Albert-HY-Jiang/Buggy-for-Neural-Navigation/README.md

# Buggy-for-Neural-Navigation

This project involves designing and building a robotic buggy capable of collecting spatial and visual data to demonstrate a neural algorithm for navigation. 

Key Features:
- ARM core microcontroller MSP432P401R programmed using C
- Ultrasonic distance sensing for obstacle detection
- Camera module for real-time image capture
- Bluetooth communication for remote control and data transmission
- Microcontroller peripherals for motor control, sensor interfacing, and data handling
