Albert-HY-Jiang/Buggy-for-Neural-Navigation/doc/weekly reports/5-1 bluetooth transfer.docx

# Bluetooth Transfer from ESP32 Cam

The ESP32 cam has embedded Bluetooth module that can be initiated using BluetoothSerial.h.

With function SerialBT.begin(device_name), the device will appear with the provide name as the Bluetooth device. It can be connected to PC with “find Bluetooth Device” option. After connected, two serial ports will be added for connection.

Bluetooth serial has the similar functionality with regular serial like read, write, print, avail, etc. It can also register call back functions using SerialBT.register_callback(btCallback); This can be used to respond to different events, like connection, data input, etc.

The Bluetooth transmission is simply writing the whole frame buffer through the serial port. It seems like this process can’t be done under the call back function, or else the data will be lost through the Bluetooth transfer. Another potential reason is that the wireless transfer is inherently unreliable. So it might be required some kind of transfer protocol to detect the missing segments.

Currently, the transfer is fine with simply writing the whole frame buffer through serial port. However, the image capture will fail after the first capture.

On the PC, it can start the connection like other serial port using pyserial.

#include "esp_camera.h"

#include "Arduino.h"

#include "FS.h" // SD Card ESP32

#include "SD_MMC.h" // SD Card ESP32

#include "soc/soc.h" // Disable brownour problems

#include "soc/rtc_cntl_reg.h" // Disable brownour problems

#include "driver/rtc_io.h"

#include <EEPROM.h> // read and write from flash memory

#include "BluetoothSerial.h" //bluetooth

// define the number of bytes you want to access

#define EEPROM_SIZE 1

RTC_DATA_ATTR int bootCount = 0;

// Pin definition for CAMERA_MODEL_AI_THINKER

#define PWDN_GPIO_NUM 32

#define RESET_GPIO_NUM -1

#define XCLK_GPIO_NUM 0

#define SIOD_GPIO_NUM 26

#define SIOC_GPIO_NUM 27

#define Y9_GPIO_NUM 35

#define Y8_GPIO_NUM 34

#define Y7_GPIO_NUM 39

#define Y6_GPIO_NUM 36

#define Y5_GPIO_NUM 21

#define Y4_GPIO_NUM 19

#define Y3_GPIO_NUM 18

#define Y2_GPIO_NUM 5

#define VSYNC_GPIO_NUM 25

#define HREF_GPIO_NUM 23

#define PCLK_GPIO_NUM 22

//Example SerialtoSerialBT

// Check if Bluetooth is available

#if !defined(CONFIG_BT_ENABLED) || !defined(CONFIG_BLUEDROID_ENABLED)

#error Bluetooth is not enabled! Please run `make menuconfig` to and enable it

#endif

// Check Serial Port Profile

#if !defined(CONFIG_BT_SPP_ENABLED)

#error Serial Port Profile for Bluetooth is not available or not enabled. It is only available for the ESP32 chip.

#endif

#define CHUNK_SIZE (size_t)32

BluetoothSerial SerialBT;

String device_name = "ESP32_CAM_BT";

void setup() {

WRITE_PERI_REG(RTC_CNTL_BROWN_OUT_REG, 0); //disable brownout detector

Serial.begin(115200);

cam_init();

bt_init();

}

void loop() {

char read;

if(SerialBT.available())

{

read = SerialBT.read();

Serial.write(read);

if(read == 't')

take_picture();

else{

Serial.print("picture not taken");

SerialBT.print("picture not taken");

}

}

}

void cam_init()

{

Serial.setDebugOutput(true);

camera_config_t config;

config.ledc_channel = LEDC_CHANNEL_0;

config.ledc_timer = LEDC_TIMER_0;

config.pin_d0 = Y2_GPIO_NUM;

config.pin_d1 = Y3_GPIO_NUM;

config.pin_d2 = Y4_GPIO_NUM;

config.pin_d3 = Y5_GPIO_NUM;

config.pin_d4 = Y6_GPIO_NUM;

config.pin_d5 = Y7_GPIO_NUM;

config.pin_d6 = Y8_GPIO_NUM;

config.pin_d7 = Y9_GPIO_NUM;

config.pin_xclk = XCLK_GPIO_NUM;

config.pin_pclk = PCLK_GPIO_NUM;

config.pin_vsync = VSYNC_GPIO_NUM;

config.pin_href = HREF_GPIO_NUM;

config.pin_sscb_sda = SIOD_GPIO_NUM;

config.pin_sscb_scl = SIOC_GPIO_NUM;

config.pin_pwdn = PWDN_GPIO_NUM;

config.pin_reset = RESET_GPIO_NUM;

config.xclk_freq_hz = 20000000;

config.pixel_format = PIXFORMAT_JPEG;

if(psramFound()){

Serial.print("Using UXGA\n");

config.frame_size = FRAMESIZE_UXGA; // FRAMESIZE_ + QVGA|CIF|VGA|SVGA|XGA|SXGA|UXGA

config.jpeg_quality = 10;

config.fb_count = 2;

} else {

Serial.print("Using SVGA\n");

config.frame_size = FRAMESIZE_SVGA;

config.jpeg_quality = 12;

config.fb_count = 1;

}

// Init Camera

esp_err_t err = esp_camera_init(&config);

if (err != ESP_OK) {

Serial.printf("Camera init failed with error 0x%x", err);

return;

}

}

void bt_init()

{

SerialBT.begin(device_name);

SerialBT.register_callback(btCallback);

Serial.println("The device started, now you can pair it with bluetooth");

}

void btCallback(esp_spp_cb_event_t event, esp_spp_cb_param_t *param){

//Serial Port Profile (SPP) API

if(event == ESP_SPP_SRV_OPEN_EVT){

/*!< When SPP is initialized, the event comes */

Serial.println("Client Connected!");

}else if(event == ESP_SPP_DATA_IND_EVT){

/*!< When SPP connection received data, the event comes, only for ESP_SPP_MODE_CB */

// Serial.printf("ESP_SPP_DATA_IND_EVT len=%d, handle=%d", param->data_ind.len, param->data_ind.handle);

// Serial.printf("value is %.*s\n", param->data_ind.len, param->data_ind.data);

// char stringRead[50];

// if(param->data_ind.len < 50)

// {

// memcpy(stringRead, param->data_ind.data, param->data_ind.len);

// stringRead[param->data_ind.len] = 0;

// Serial.printf("value is %.*s\n", param->data_ind.len+1, stringRead);

// if(stringRead[0] == 't')

// {

// Serial.printf("take picture\n");

// take_picture();

// }

// }

// else

// {

// Serial.printf("picture not taken\n");

// }

}

}

void take_picture()

{

camera_fb_t * fb = NULL;

// Take Picture with Camera

pinMode(4, OUTPUT);

digitalWrite(4, HIGH);

fb = esp_camera_fb_get();

delay(1000);//This is key to avoid an issue with the image being very dark and green. If needed adjust total delay time.

fb = esp_camera_fb_get();

digitalWrite(4, LOW);

if(!fb) {

esp_camera_fb_return(fb);

Serial.println("Camera capture failed");

SerialBT.println("Camera capture failed");

return;

}

Serial.printf("transmission started\n");

Serial.printf("%u\n",fb->len);

SerialBT.printf("transmission started\n");

SerialBT.printf("%u\n",fb->len);

SerialBT.flush();

delay(10);

// size_t len = 0;

// while(len < fb->len){

// int packet_size = min(CHUNK_SIZE, fb->len - len);

// SerialBT.write(fb->buf+len, packet_size);

// Serial.printf("%u\n", len);

// len += CHUNK_SIZE;

// SerialBT.flush();

// delay(1);

// }

SerialBT.write(fb->buf, fb->len);

SerialBT.flush();

esp_camera_fb_return(fb);

digitalWrite(4, LOW);

}
