Albert-HY-Jiang/Buggy-for-Neural-Navigation/doc/report/ECE397 SP25 Albert Jiang Final Report.docx

# Robotic Buggy with Camera and Ultrasonic Sensor

# Abstract

The project is to develop a buggy that can collect visual data and measure distance while traversing through a maze. It adds the ESP32-CAM camera module to the previous version of buggy that has motors and ultrasonic sensor. The image captured by ESP32-CAM will be transmitted with the distance data through Bluetooth module embedded within it. To receive the data, a Python script is used to establish Bluetooth Connection as a serial port and save the image as JPG file with the time stamp and the distance as the file name.

# Goals

The goal of this project is to develop an enhanced buggy that integrates an ESP32-CAM module to capture and transmit visual and distance data via Bluetooth.

# Background

Bluetooth is a short-range wireless communication standard. Bluetooth uses low power wireless link at 2.4GHz, giving it a short range of 10 meters and vulnerable to interference. It is mainly used for portable devices to exchange files with host, like wireless headphone or speaker to mobile phone or laptop. (1)

# Method

The buggy has four main components: MSP432P401R microcontroller (MSP432), ESP32-CAM, HC-SR04 ultrasonic sensor, and two motors with H-bridge. The connection is shown in the diagram below.

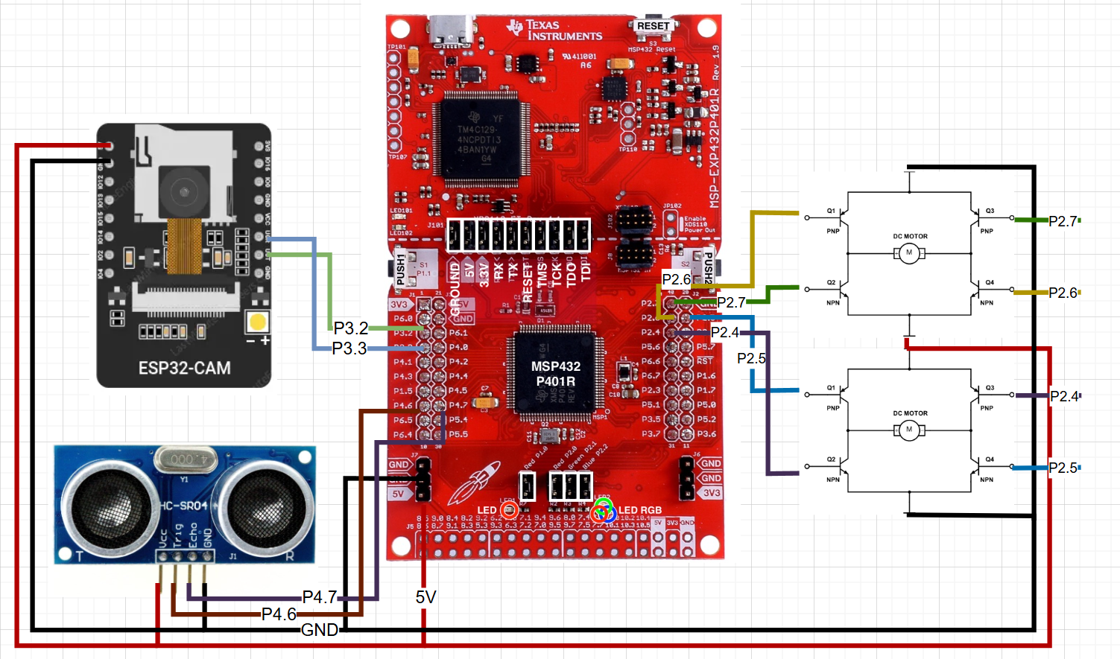
[picture p2: figure]

Figure 1. Schematic of the Buggy

The motor and the ultrasonic sensor are using the same method as the previous version, except the Trig and Echo pins for the ultrasonic sensor are moved to P4.6 and P4.7. And the previous code has been organized into different files based on the functionality. See Appendix for the code. The ESP32-CAM is connected to MSP432 by the UART port. So, they can communicate with the byte stream.

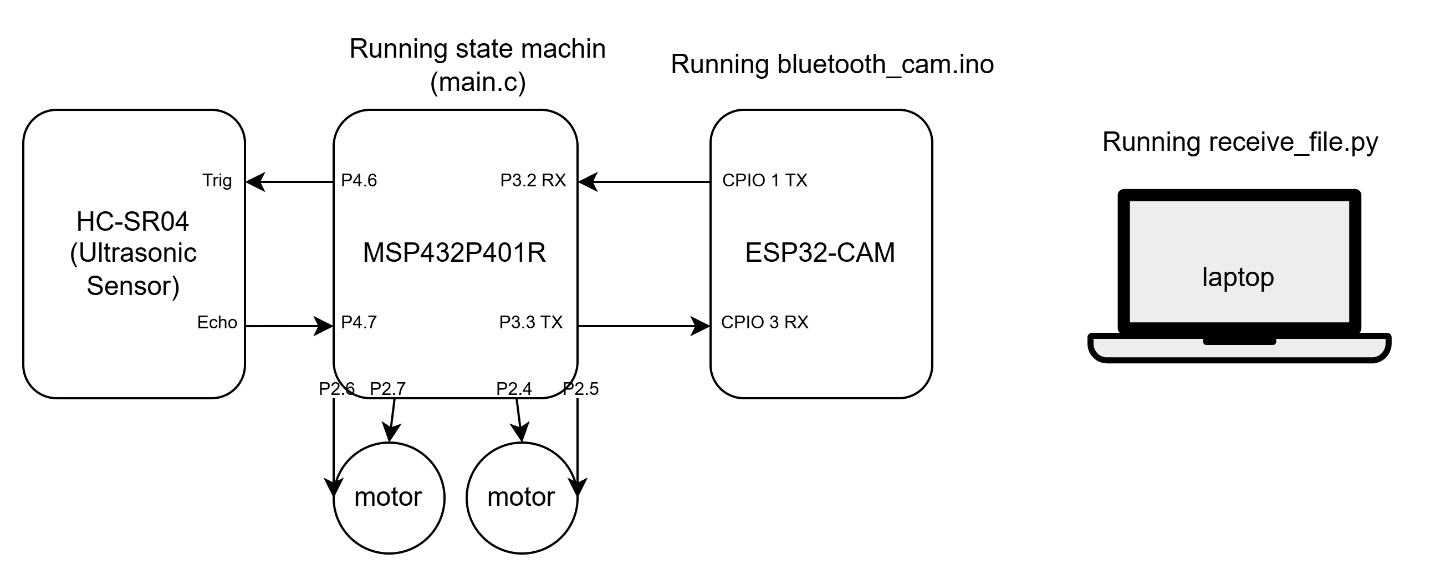
[picture p3: figure]

Figure 2. Diagram of the Buggy Set-up

## MSP432

The buggy has a state machine in MSP432 to control its behavior. It has four states: INIT, IDLE, MOVE, and SCAN. The buggy starts with INIT state to initialize all components.

case INIT:

//this state initialize all components

Clock_init();

motors_init(); //motors for moving

UART2_init(); //uart2(3.2, 3.3) for communicating with ESP32 cam

TIMERA0_init();

US_init();

currState = IDLE;

break;

Then it moves to IDLE state to wait for the ESP32-CAM to be ready. If it receives “go” from the camera module, it enables interrupt service routine to start the timer and ultrasonic sensor. Then it proceeds to the MOVE state.

case IDLE:

//this state wait for the ESP32 cam to be ready and send "go" through uart port

UART2_gets(readbuf);

if(strncmp(readbuf, "go",2) == 0)

{

__enable_irq();

// enables interrupts to start timer for time stamps, irq for ultrasonic sensor

currState = MOVE; // starts moving

}

break;

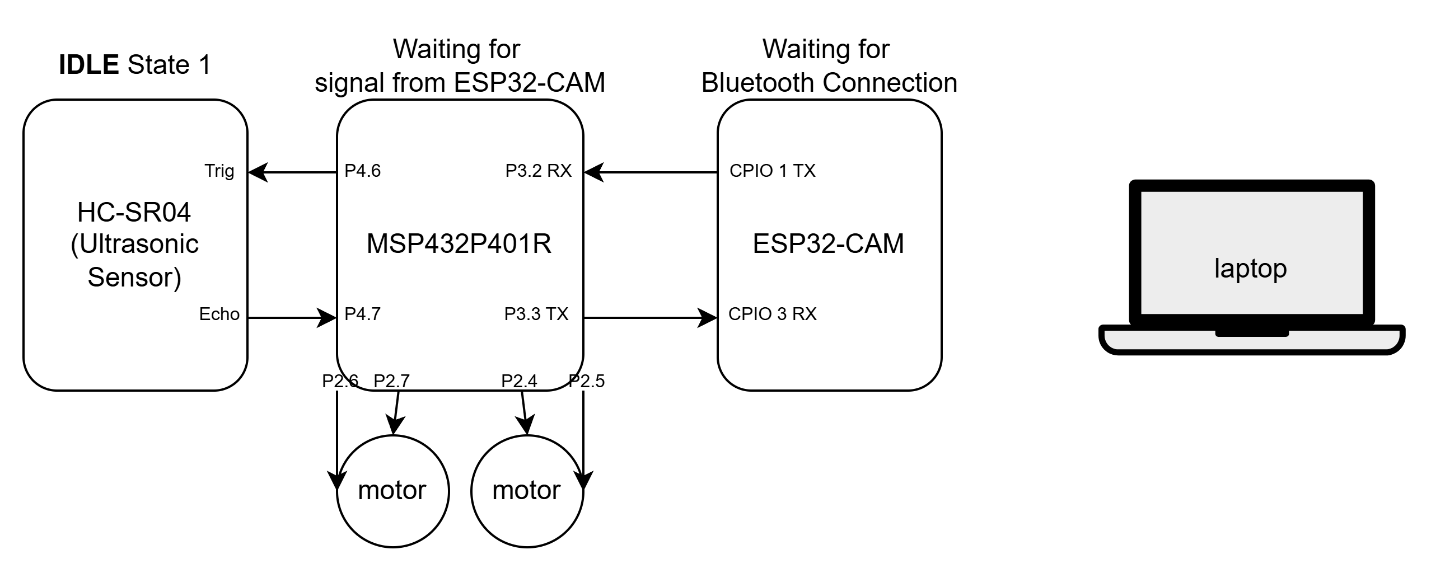
[picture p4: figure]
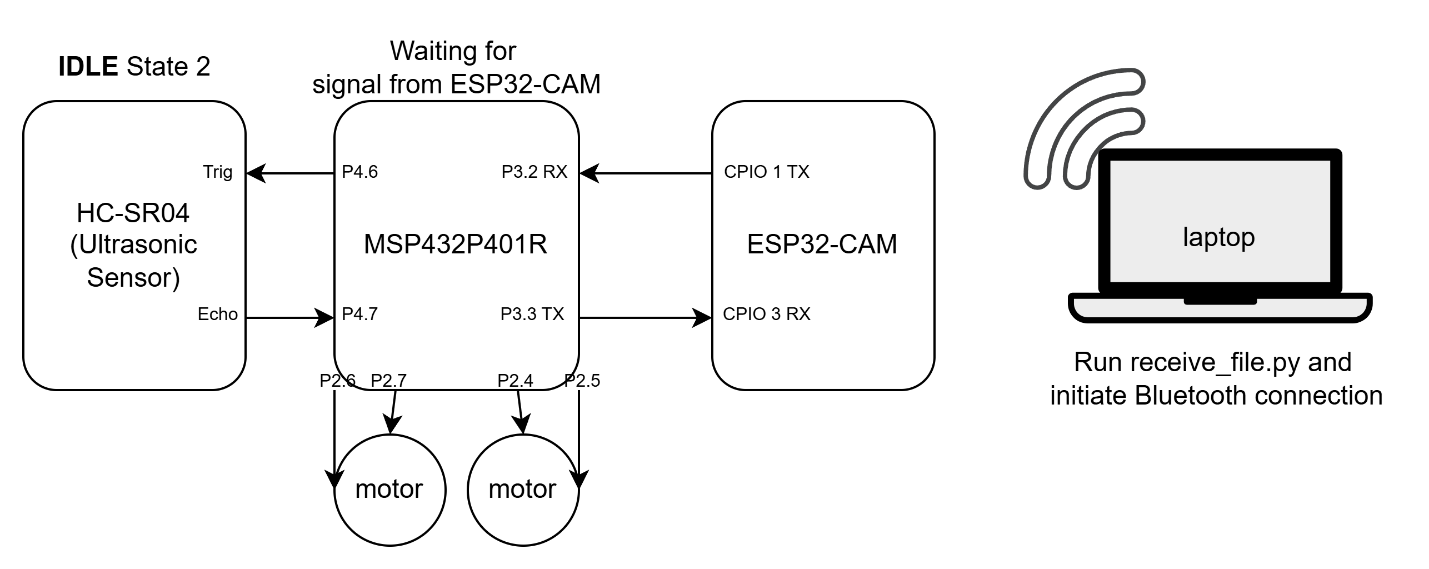
[picture p5: figure]
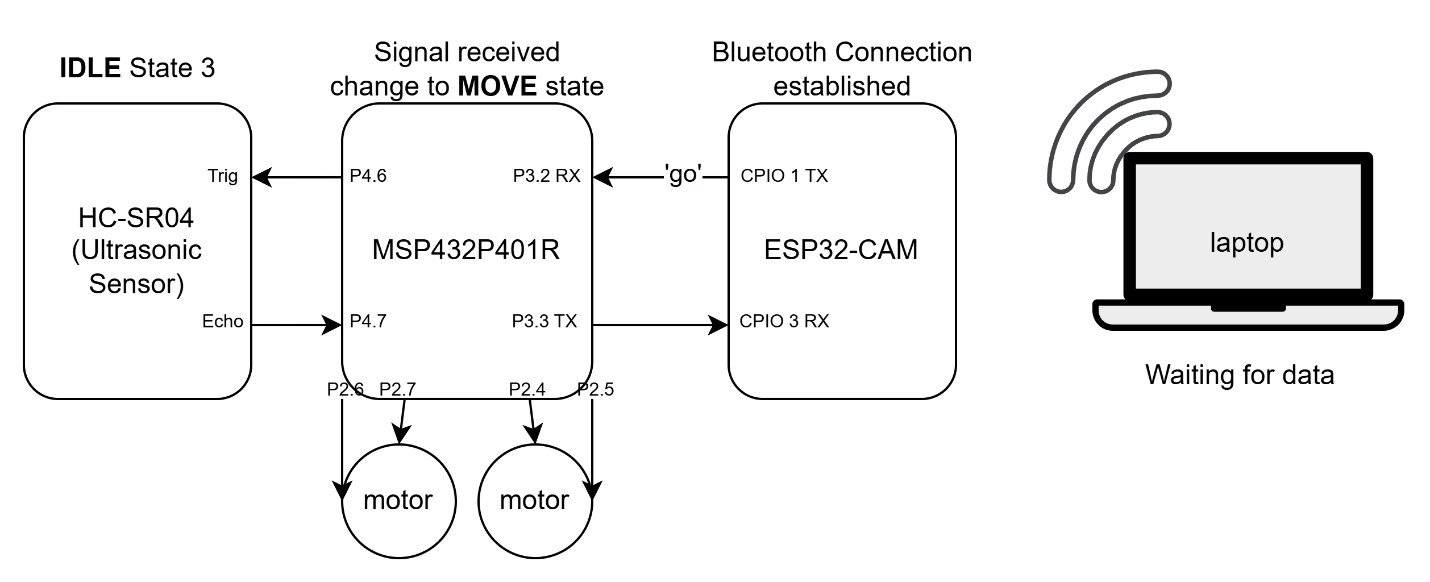
[picture p6: figure]

Figure 3. Flow Chart of IDLE State

In the MOVE state, the buggy will move forward and start scanning. The step buggy takes will be increased each time, so with the turn, the buggy will move in a triangular pattern.

case MOVE:

forward(unit_step * step); //the forward steps will gradually increase

step++;

currState = SCAN;

break;

In the SCAN state, the buggy will take two 120 degree turns. For each turn, it measures the distance by the ultrasonic sensor and gets the current time stamp. It sends the information to the ESP32-CAM through UART2 and waits for the ready signal to move on. It will end up taking a 240 degree turn and then change to MOVE state.

case SCAN:

for(i = 0; i < 2; i++){

distance = measure_dist();

time_stamp = get_time_stamp();

sprintf(writebuf, "%s, %d\n", time_stamp, distance); // format the output string

UART2_puts(writebuf); //write to ESP32 cam

UART2_gets(readbuf); //wait for ready signal from ESP32 cam

turn(-120); //it will end up turning for 240 degree

}

currState = MOVE;

break;

}

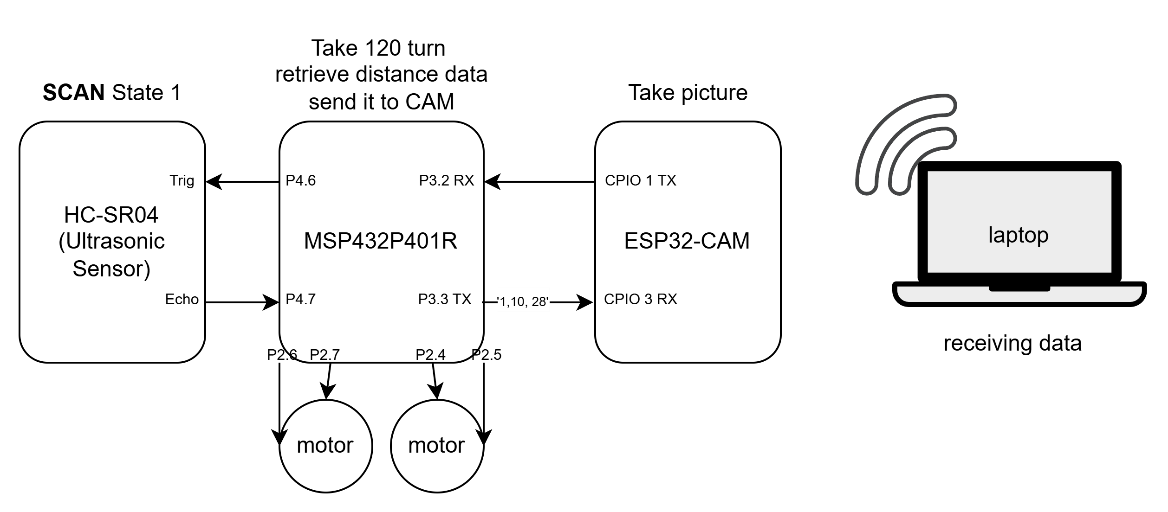
[picture p7: figure]
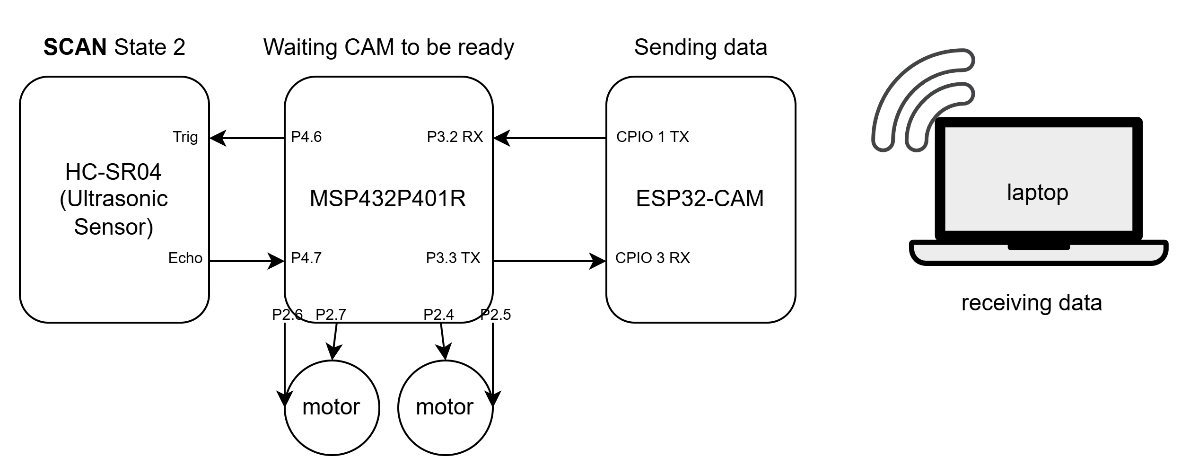
[picture p8: figure]
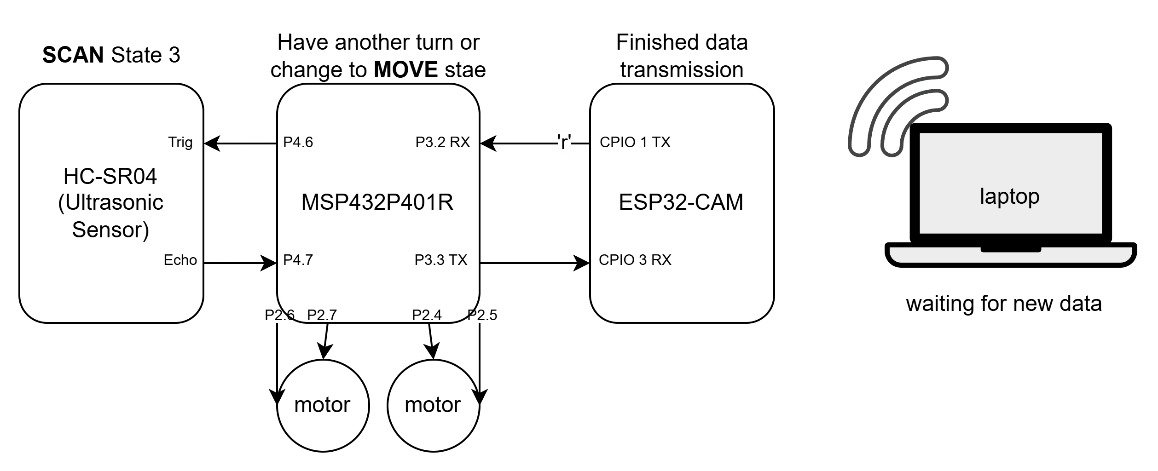
[picture p9: figure]

Figure 4. Flow Chart of SCAN State

The buggy will continue to oscillate between MOVE and SCAN state to move in triangular spiral and collect images. The reset button on the MSP432 can be used to break out of this loop. The buggy will then be reset and waiting in IDLE state. To start the run again, the laptop needs to restart the python script to establish Bluetooth connection again.

## ESP32-CAM

The ESP32-CAM is also a microcontroller, and it can be programmed using Arduino IDE

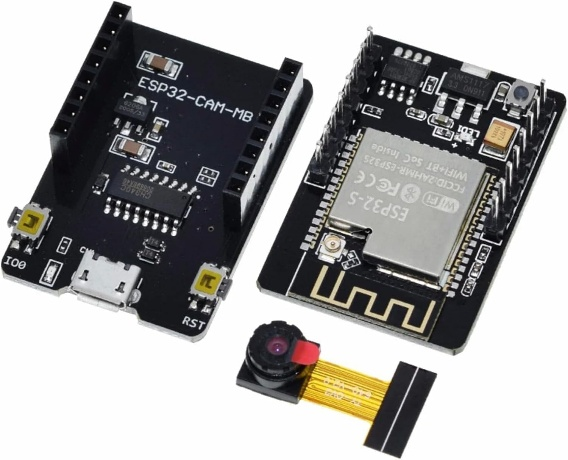
[picture p10: figure]

Figure 5. ESP32-CAm with OV2640 Camera

The ESP32-CAM doesn’t have a micro-USB port. It can be connected with ESP32-CAM-MB and use its micro-USB port. The micro-USB port is used for uploading the compiled program. In case when ESP32-CAM-MB isn’t available, FTDI jumper can be used for converting micro-USB to UART serial port. (2)

To compile ESP32 on Arduino, add the following link to Arduino IDE under Preferences->Additional Boards Manager->Additional Boards Manager URLs

https://raw.githubusercontent.com/espressif/arduino-esp32/gh-pages/package_esp32_index.json

Then go to Tools->Board->Board Manager. Install ESP32 by Expressif Systems.

Once Installed, go to Tools->Board->ESP32 Arduino->AI Thinker ESP32-CAM.

Connect ESP32 Cam and upload compiled code.

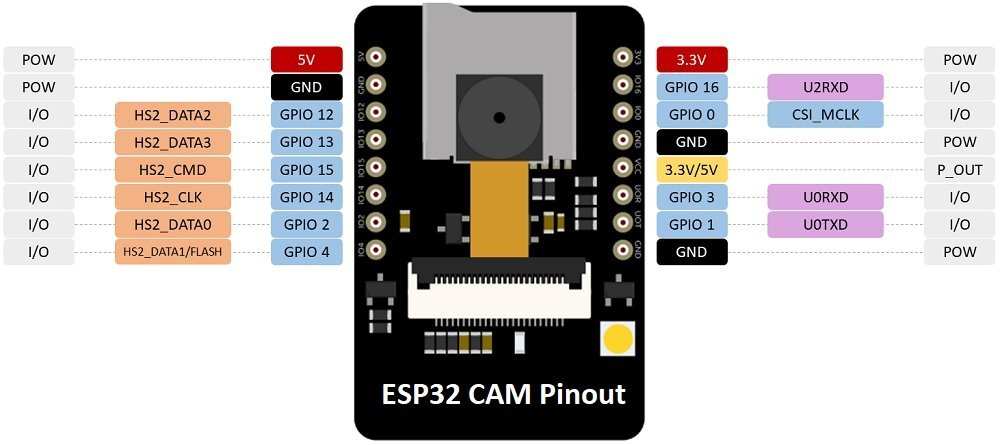
[picture p11: figure]
ESP32-CAM AI-Thinker: Pinout, GPIO Pins, Features and How to ...

Figure 6. ESP32 CAM Pin Configuration

## Serial Port

ESP32-CAM only has one full UART port (GPIO 1 and 3), which in our case will be used to communicate with MSP432 with its UART2 (P3.2 and P3.3). GPIO 1 and 3 are also used for sketch uploading. And because of the board configuration of ESP32-CAM, this serial port isn’t compatible with terminal emulator like Teraterm. It can be properly interpreted by Arduino serial monitor if the board configuration is loaded. The problem seems to be that ESP32-CAM disabled DTR and RTS, and if these are used, the board will keep rebooting. However, the exact solution to configure Teraterm to fit with this setting is still unknown. This will also mess up the transmission if directly connected to external Bluetooth module, like HC-06, for serial transmission. Direct connection to other microcontrollers like MSP432 through UART seems to be fine.

In order to receive serial data on a computer, pyserial library is used. It requires Python 2.7 or Python 3.4 and newer, which can be downloaded from official website with all released version https://www.python.org/downloads/ . And pyserial can be installed through pip through command line “python -m pip install pyserial”. (3) To establish the connection, it needs to create a Serial object with the port name and baud rate, like the example below:

com = serial.Serial()

com.port = port_name

com.baudrate = baud

com.timeout = 1

com.dsrdtr = False

com.open()

To resolve the issue of asserting DTR and RTS, it needs to initiate a port object and set dsrdtr to False before establishing the connection. With connection properly established, it can receive bytes from serial port and save it as jpg file.

## Camera on ESP32-CAM

ESP32-CAM needs to be configured and initialized to capture images. The specific configuration is in the Appendix. After it properly initialized, function esp_camera_fb_get() will return a struct of frame buffer(4):

typedef struct {

uint8_t * buf; /*!< Pointer to the pixel data */

size_t len; /*!< Length of the buffer in bytes */

size_t width; /*!< Width of the buffer in pixels */

size_t height; /*!< Height of the buffer in pixels */

pixformat_t format; /*!< Format of the pixel data */

struct timeval timestamp; /*!< Timestamp since boot of the first DMA buffer of the frame */

} camera_fb_t;

The frame buffer is at the buf pointer with the size of len. If it is properly configured, the buffer will be in the jpeg format. And these data can be transmitted as byte stream through serial port with Serial.write(fb->buf, fb->len). After each usage of the frame buffer, the memory needs to be freed by function esp_camera_fb_return(fb).

To take better quality pictures, it is recommended to use the flashlight at GPIO 4 and take one picture first to let the camera adjust itself and take the picture again. Like the example below

## Bluetooth Serial

camera_fb_t * fb = NULL;

// Take Picture with Camera

pinMode(4, OUTPUT); //GPIO 4 is the LED flashlight

digitalWrite(4, HIGH);

fb = esp_camera_fb_get();

esp_camera_fb_return(fb); //need to free frame buffer to prevent memory overflow

//Taking the picture twice allows the camera to adjust itself. It usually works better under brighter environment

delay(1000);

fb = esp_camera_fb_get();

digitalWrite(4, LOW);

The ESP32-CAM has embedded Bluetooth module that can be initiated using BluetoothSerial.h.

With the function SerialBT.begin(device_name), ESP32-CAM will appear with the provide name as the Bluetooth device. It can be connected to a computer with “find Bluetooth Device” option. After connected, two serial ports will be added for connection.

void btCallback(esp_spp_cb_event_t event, esp_spp_cb_param_t *param){

if(event == ESP_SPP_SRV_OPEN_EVT){

//this event corresponds to establishing bluetooth connection

//The "go" triggers MSP432 to start moving

Serial.println("go");

}

}

Bluetooth serial has similar functionality as regular serial port like read, write, print, avail, etc. It can also register call back functions using SerialBT.register_callback(btCallback); This is used to detect the event of establishing Bluetooth connection.

When the connection is established, ESP32-CAM sends the String “go\n” to the MSP432 through default serial port (GPIO 1 and 3). This corresponds to the “go” MSP432 is waiting for in the IDLE state.

After the connection is established, ESP32-CAM will be waiting for MSP432 to send the time stamp and the distance through UART. Each time ESP32-CAM receives the data, it will take a picture and transmit all the information through Bluetooth. The byte stream for each picture follows the structure below, so the receiver can parse all information properly.

/*

* structure of bytes stream transferred

* transmission started\n

* time stamp, distance\n

* file size(bytes)\n

* file bytes

*/

The Bluetooth transmission is similar with regular serial port with SerialBT.write(fb->buf, fb->len). It seems like this process can’t be done under the call back function, or else the data will be lost through Bluetooth transfer. After all transmission through Bluetooth, ESP32-CAM will send an arbitrary character to MSP432 as ready signal, marking it’s ready for the next picture.

## Python Script

The Python script is used to receive images on the computer. The pyserial library can read bytes from the serial port until a newline character by readline() or until the given number of bytes with read. After receiving all the information, it will create an image file with the time stamp and distance as the file name.

if(value == b'transmission started\n'):

name = com.readline()

file_name = str(name, encoding="UTF-8")[:-1]

print(file_name)

value = com.readline()

line = str(value, encoding="UTF-8")

file_len = int(line)

print(f'file size: {file_len} bytes')

start = time.time() #calculate tranmission time

file_buf = com.read(file_len)

print(len(file_buf))

with open(file_name+".jpg", "wb") as f: #save the image with time stamp, distance as file name

f.write(file_buf)

end = time.time()

print("picture captured")

print(end - start)

num +=1

## Procedures

1. Program MSP432 and ESP32-CAM
2. Connect all components together and power on, the buggy should then be waiting for Bluetooth connection
3. If the ESP32-CAM hasn’t been added as Bluetooth devices, use “Find Bluetooth Device” option on the computer to add it.
4. Run the Python Script on the computer, the buggy will start running and sending images to the computer
5. To stop the buggy, press the reset button on the MSP432. The buggy will reboot and waiting for Bluetooth connection.
6. To start another run, run the Python script on the computer again.

# Difficulties and Solutions

A summary of difficulties encountered during the project and their solutions

- Can’t read from ESP32-CAM serial port and the board is halted

Mostly likely because ESP32-CAM disabled DTR and RTS, and if these are used, the board will keep rebooting. So make sure the other end also disable these features. Serial monitor in Arduino IDE can communicate with it properly if the corresponding board configuration is loaded. If the connection is established through pyserial, initiate a port object and set dsrdtr to False before establishing the connection, like the example below

com = serial.Serial()

com.port = port_name

com.baudrate = baud

com.timeout = 1

com.dsrdtr = False

com.open()

- Bytes are dropped during Bluetooth transmission

Avoid starting the transmission after the callback function. This is probably because callback function limits the stack size to handle function calls and frame buffer. Smaller file size means a lower chance of dropping, and the size of image can be adjusted by setting config.frame_size to FRAMESIZE_ + QVGA, CIF, VGA, SVGA, XGA, SXGA, UXGA(size in increasing order). The regular Bluetooth connection should be reliable enough. To ensure a fully reliable transfer, certain kinds of protocol need to be implemented. For example, similar to TCP, the image file can be divided into packets and only send out the next packet after the receiver acknowledged the previous packet. However, this is an overkill and will significantly slow down the transmission.

- esp_camera_fb_get() fails

Probably because the previous frame buffer wasn’t freed by esp_camera_fb_return(). The camera can only hold the number of frame buffer according to config.fb_count

- picture is green with a lot of noise

The camera performs better under bright light. The quality of the picture can be improved by having multiple tries because the camera will configure itself after taking pictures.

# Result and Conclusion

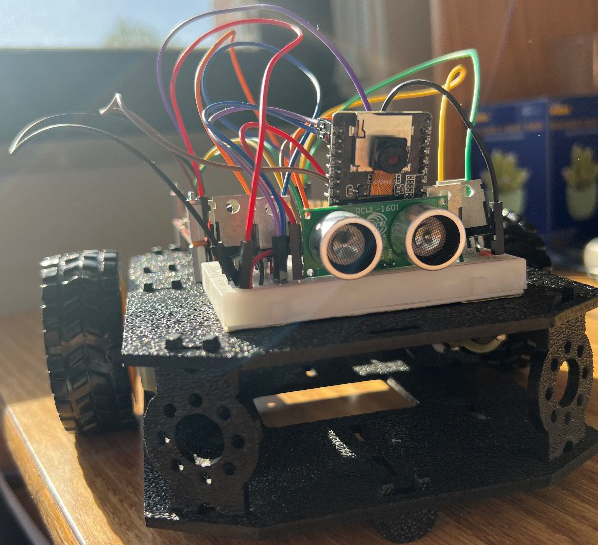
[picture p12: figure]
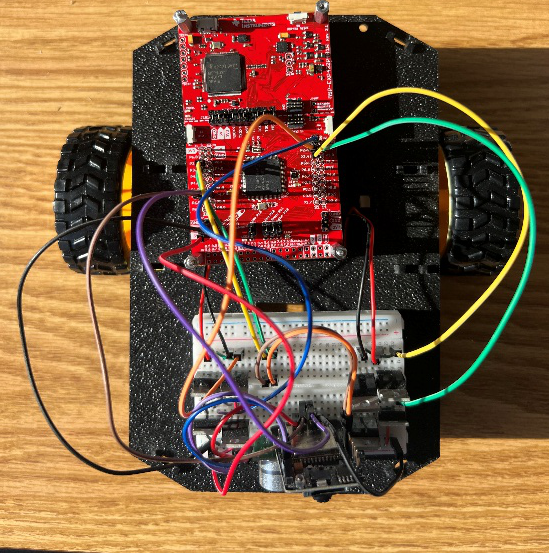
[picture p13: figure]

Figure 7. Side and Top view of Buggy

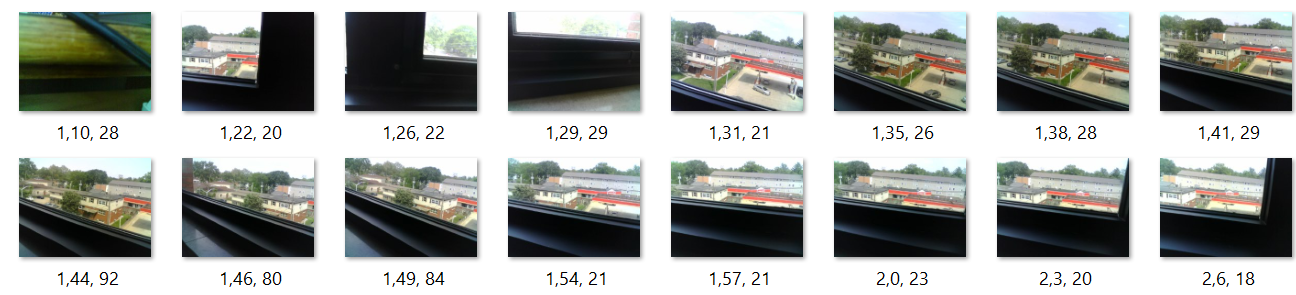
[picture p14: figure]

Figure 8. Received Example Images

The figures above are the final version of the buggy, and the image received in the test run. The Python Script can continuously receive images captured by the buggy and create files accordingly. This fulfills the goal of the project.

To further improve the buggy, we could use PCB for the circuit connection, which will greatly reduce the size of the buggy. The picture quality can be improved by using a different camera module. Bluetooth transmission is relatively slow due to its baud rate. We can speed up this process by changing to other wireless transmission like WiFi. The current buggy only takes command for starting the traversal and can only be terminated by the reset button. With Bluetooth or other transmission, it can potentially take in more commands like pause, continue, or even remote control of directions.

Reference

1. "About us – Bluetooth Technology Website". Bluetooth.com.
2. "ESP32-CAM Complete Guide". https://www.diyengineers.com/2023/04/13/esp32-cam-complete-guide/
3. "pyserial documentation". https://pyserial.readthedocs.io/en/latest/pyserial.html
4. "ESP32 Camera Driver". https://github.com/espressif/esp32-camera/blob/master/README.md

# Appendix

Box folder for code https://uofi.box.com/s/8n2sgsv3pwzodkihhqbszfubwpxs37ac

bluetooth_cam.ino

#include "esp_camera.h"

#include "Arduino.h"

#include "FS.h" // SD Card ESP32

#include "SD_MMC.h" // SD Card ESP32

#include "soc/soc.h" // Disable brownour problems

#include "soc/rtc_cntl_reg.h" // Disable brownour problems

#include "driver/rtc_io.h"

#include <EEPROM.h> // read and write from flash memory

#include "BluetoothSerial.h" //bluetooth

// define the number of bytes you want to access

#define EEPROM_SIZE 1

RTC_DATA_ATTR int bootCount = 0;

// Pin definition for CAMERA_MODEL_AI_THINKER

#define PWDN_GPIO_NUM 32

#define RESET_GPIO_NUM -1

#define XCLK_GPIO_NUM 0

#define SIOD_GPIO_NUM 26

#define SIOC_GPIO_NUM 27

#define Y9_GPIO_NUM 35

#define Y8_GPIO_NUM 34

#define Y7_GPIO_NUM 39

#define Y6_GPIO_NUM 36

#define Y5_GPIO_NUM 21

#define Y4_GPIO_NUM 19

#define Y3_GPIO_NUM 18

#define Y2_GPIO_NUM 5

#define VSYNC_GPIO_NUM 25

#define HREF_GPIO_NUM 23

#define PCLK_GPIO_NUM 22

//Example SerialtoSerialBT

// Check if Bluetooth is available

#if !defined(CONFIG_BT_ENABLED) || !defined(CONFIG_BLUEDROID_ENABLED)

#error Bluetooth is not enabled! Please run `make menuconfig` to and enable it

#endif

// Check Serial Port Profile

#if !defined(CONFIG_BT_SPP_ENABLED)

#error Serial Port Profile for Bluetooth is not available or not enabled. It is only available for the ESP32 chip.

#endif

#define CHUNK_SIZE (size_t)32

BluetoothSerial SerialBT;

String device_name = "ESP32_CAM_BT";

void setup() {

WRITE_PERI_REG(RTC_CNTL_BROWN_OUT_REG, 0); //disable brownout detector

Serial.begin(9600); //The MSP432 will be communicating through default serial port (GPIO 1 TX, GPIO 3 RX)

cam_init();

bt_init();

}

void loop() {

String read;

if(Serial.available())

{

//read time stamp and distance from MSP432

read = Serial.readString();

/*

* structure of bytes stream transferred

* transmission started\n

* time stamp, distance\n

* file size(bytes)\n

* file bytes

*/

SerialBT.printf("transmission started\n");

SerialBT.print(read);

take_picture();

//tell MSP432 the cam is ready again

Serial.print("r\n");

}

}

void cam_init()

{

Serial.setDebugOutput(false);

camera_config_t config;

config.ledc_channel = LEDC_CHANNEL_0;

config.ledc_timer = LEDC_TIMER_0;

config.pin_d0 = Y2_GPIO_NUM;

config.pin_d1 = Y3_GPIO_NUM;

config.pin_d2 = Y4_GPIO_NUM;

config.pin_d3 = Y5_GPIO_NUM;

config.pin_d4 = Y6_GPIO_NUM;

config.pin_d5 = Y7_GPIO_NUM;

config.pin_d6 = Y8_GPIO_NUM;

config.pin_d7 = Y9_GPIO_NUM;

config.pin_xclk = XCLK_GPIO_NUM;

config.pin_pclk = PCLK_GPIO_NUM;

config.pin_vsync = VSYNC_GPIO_NUM;

config.pin_href = HREF_GPIO_NUM;

config.pin_sscb_sda = SIOD_GPIO_NUM;

config.pin_sscb_scl = SIOC_GPIO_NUM;

config.pin_pwdn = PWDN_GPIO_NUM;

config.pin_reset = RESET_GPIO_NUM;

config.xclk_freq_hz = 20000000;

config.pixel_format = PIXFORMAT_JPEG;

//ESP32 cam will most likelt have psram, so it will be using UXGA

if(psramFound()){

Serial.print("Using UXGA\n");

config.frame_size = FRAMESIZE_UXGA; // FRAMESIZE_ + QVGA|CIF|VGA|SVGA|XGA|SXGA|UXGA

config.jpeg_quality = 10;

config.fb_count = 2; //it can holds two frame buffer at the same time

} else {

Serial.print("Using SVGA\n");

config.frame_size = FRAMESIZE_SVGA;

config.jpeg_quality = 12;

config.fb_count = 1;

}

// Init Camera

esp_err_t err = esp_camera_init(&config);

if (err != ESP_OK) {

Serial.printf("Camera init failed with error 0x%x", err);

return;

}

}

void bt_init()

{

SerialBT.begin(device_name);

SerialBT.register_callback(btCallback);

//Serial.println("The device started, now you can pair it with bluetooth");

}

void btCallback(esp_spp_cb_event_t event, esp_spp_cb_param_t *param){

//Serial Port Profile (SPP) API

if(event == ESP_SPP_SRV_OPEN_EVT){

//this event corresponds to establishing bluetooth connection

//The "go" triggers MSP432 to start moving

Serial.println("go");

}

}

void take_picture()

{

camera_fb_t * fb = NULL;

// Take Picture with Camera

pinMode(4, OUTPUT); //GPIO 4 is the LED flashlight

digitalWrite(4, HIGH);

fb = esp_camera_fb_get();

esp_camera_fb_return(fb); //need to free frame buffer to prevent memory overflow

//Taking the picture twice allows the camera to adjust itself. It usually works better under brighter environment

delay(1000);

fb = esp_camera_fb_get();

digitalWrite(4, LOW);

if(!fb) {

//notify each side the capture failed

Serial.println("Camera capture failed");

SerialBT.println("Camera capture failed");

return;

}

SerialBT.printf("%u\n",fb->len);

SerialBT.flush();

delay(10);

SerialBT.write(fb->buf, fb->len);

SerialBT.flush(); //make sure to transmit the whole file

esp_camera_fb_return(fb);

}

receive_file.py

import serial, time

import sys

if __name__ == '__main__':

if len(sys.argv) != 3:

#using the following command to run the script, baudrate is 115200 with bluetooth

print("python script serial_port baudrate")

#using the following command to list the available ports

print("python -m serial.tools.list_ports")

exit()

port_name = sys.argv[1]

baud = sys.argv[2]

#Create a Serial object, configure the parameters, then open the connection

#This is especially important when using wired connection with ESP32 cam

#because it will try to use dsrdtr regardless of the setting, which reset the board

com = serial.Serial()

com.port = port_name

com.baudrate = baud

com.timeout = 10

com.dsrdtr = False

com.open()

print("serial connected")

num = 1 #number of pictures received

while True:

print(num)

value = com.readline()

line = str(value, encoding="UTF-8")

print(line)

'''

structure of bytes stream transferred:

transmission started\n

time stamp, distance\n

file size(bytes)\n

file bytes

'''

if(value == b'transmission started\n'):

name = com.readline()

file_name = str(name, encoding="UTF-8")[:-1]

print(file_name)

value = com.readline()

line = str(value, encoding="UTF-8")

file_len = int(line)

print(f'file size: {file_len} bytes')

start = time.time() #calculate tranmission time

file_buf = com.read(file_len)

print(len(file_buf))

with open(file_name+".jpg", "wb") as f: #save the image with time stamp, distance as file name

f.write(file_buf)

end = time.time()

print("picture captured")

print(end - start)

num +=1

main.c

#include "msp.h"

#include <stdio.h>

#include <string.h>

#include "uart.h"

#include "motor.h"

#include "us.h"

#define unit_step 1000

enum buggieState {

INIT,

IDLE,

MOVE,

SCAN

};

void main(void)

{

WDT_A->CTL = WDT_A_CTL_PW | // Stop watchdog timer

WDT_A_CTL_HOLD;

char readbuf[128];

char writebuf[128];

int step = 1; //number of forward step taken at each round

long distance; //distance measured by ultrasonic sensor

char* time_stamp; //time stamp starting

int i;

enum buggieState currState = INIT;

while(1)

{

switch(currState)

{

case INIT:

//this state initialize all components

Clock_init();

motors_init(); //motors for moving

UART2_init(); //uart2(3.2, 3.3) for communicating with ESP32 cam

TIMERA0_init();

US_init();

currState = IDLE;

break;

case IDLE:

//this state wait for the ESP32 cam to be ready and send "go" through uart port

UART2_gets(readbuf);

if(strncmp(readbuf, "go",2) == 0)

{

__enable_irq(); // enables interrupts to start timer for time stamps, irq for ultrasonic sensor

currState = MOVE; // starts moving

}

break;

case MOVE:

forward(unit_step * step); //the forward steps will gradually increase

step++;

currState = SCAN;

break;

case SCAN:

for(i = 0; i < 2; i++){

distance = measure_dist();

time_stamp = get_time_stamp();

sprintf(writebuf, "%s, %d\n", time_stamp, distance); // format the output string

UART2_puts(writebuf); //write to ESP32 cam

UART2_gets(readbuf); //wait for ready signal from ESP32 cam

turn(-120); //it will end up turning for 240 degree

}

currState = MOVE;

break;

}

}

}

motor.h

#include "msp.h"

#include <stdio.h>

#include "SysTick0.h"

void motors_init(); // Initialize ports controlling H-Bridge

void forward(int time); // Move buggy forward for a time in ms

void backward(int time); // Move buggy backward for a time in ms

void turn(int angle); // Turn buggy by an angle in degrees

motor.c

#include "motor.h"

#define timePerAngle 10 // Constant to translate

void left_fw(); // Helper functions for H-Bridge

void left_bw();

void left_off();

void right_fw();

void right_bw();

void right_off();

void motors_init() {

P2->OUT = 0x00; // Set P2.4-2.7 to low GPIO out, 2.4, 2.5 for the left, 2.6, 2.7 for the right

P2->SEL0 = 0x00;

P2->SEL1 = 0x00;

P2->DIR = 0xF0;

return;

}

void left_fw() {

P2->OUT &= (~BIT5);

P2->OUT |= BIT4;

return;

}

void left_bw() {

P2->OUT &= (~BIT4);

P2->OUT |= BIT5;

return;

}

void left_off() {

P2->OUT &= (~(BIT4 | BIT5));

return;

}

void right_fw() {

P2->OUT &= (~BIT7);

P2->OUT |= BIT6;

return;

}

void right_bw() {

P2->OUT &= (~BIT6);

P2->OUT |= BIT7;

return;

}

void right_off() {

P2->OUT &= (~(BIT6 | BIT7));

return;

}

void forward(int time) {

right_fw(); // Make both motors spin forward for a set time

left_fw();

SysTick_Delayms(time);

right_off(); // Turn off both motors

left_off();

return;

}

void backward(int time) {

right_bw(); // Make both motors spin backwards for a set time

left_bw();

SysTick_Delayms(time);

right_off(); // Turn off both motors

left_off();

return;

}

void turn(int angle) {

if (angle == 0 || angle > 180 || angle < -180) { // Invalid angles

} else if (angle > 0){ // Counter-clockwise turns, spin right wheel forward and left wheel backwards

right_fw();

left_bw();

SysTick_Delayms(angle * timePerAngle);

right_off();

left_off();

} else { // Clockwise turns, spin left wheel forward and right wheel backwards

right_bw();

left_fw();

SysTick_Delayms(angle * (-1) * timePerAngle);

right_off();

left_off();

}

return;

}

uart.h

#include "msp.h"

//UART0 is at the micro-USB port. UART2 is at pin 3.2 and pin 3.3. These two ports allow serial communication between the microcontroller and the ESP32-CAM.

//This function initializes UART0.

void UART0_init();

//This function sends string through UART0 by spin waiting.

int UART0_puts(const char *str);

//This function initializes UART2.

void UART2_init();

//This function sends string through UART2 by spin waiting. The transmit pin is pin 3.3.

int UART2_puts(const char *str);

//This function receives string through UART2 by spin waiting. The receive pin is pin 3.2.

//It returns after the receiving line feed ‘\n’ or end of the string ‘\0’

int UART2_gets(char *str);

uart.c

#include "msp.h"

#include "uart.h"

void UART0_init();

int UART0_puts(const char *str);

void UART2_init();

int UART2_puts(const char *str);

int UART2_gets(char *str);

/**

* This function is initializing the UART0(micro-USB port) for sending distance message to the console with baud rate of 9600

*

*/

void UART0_init()

{

// Configure UART pins

P1->SEL0 |= BIT2 | BIT3; // set 2-UART pin as secondary function

// Configure UART

EUSCI_A0->CTLW0 |= EUSCI_A_CTLW0_SWRST; // Put eUSCI in reset

EUSCI_A0->CTLW0 |= EUSCI_B_CTLW0_SSEL__SMCLK; // Configure eUSCI clock source for SMCLK

// Baud Rate calculation

// 12000000/(16*9600) = 78.125

// Fractional portion = 0.125

// User's Guide Table 21-4: UCBRSx = 0x10

// UCBRFx = int ( (78.125-78)*16) = 2

EUSCI_A0->BRW = 78; // 12000000/16/9600

EUSCI_A0->MCTLW = (2 << EUSCI_A_MCTLW_BRF_OFS) |

EUSCI_A_MCTLW_OS16;

EUSCI_A0->CTLW0 &= ~EUSCI_A_CTLW0_SWRST; // take eUSCI out of reset mode

EUSCI_A0->IFG &= ~EUSCI_A_IFG_RXIFG; // Clear eUSCI RX interrupt flag

EUSCI_A0->IE &= ~EUSCI_A_IE_RXIE; // Disable USCI_A0 RX interrupt

}

/**

* This function puts a string to transmit buffer in the UART0, which will be sent to console

*/

int UART0_puts(const char *str)

{

int status = -1;

if (str != '\0')

{

status = 0;

while (*str != '\0')

{

/* Wait for the transmit buffer to be ready */

while (!(EUSCI_A0->IFG & EUSCI_A_IFG_TXIFG))

;

/* Transmit data */

EUSCI_A0->TXBUF = *str;

/* If there is a line-feed, add a carriage return */

if (*str == '\n')

{

/* Wait for the transmit buffer to be ready */

while (!(EUSCI_A0->IFG & EUSCI_A_IFG_TXIFG))

;

EUSCI_A0->TXBUF = '\r';

}

str++;

}

}

return status;

}

/**

* This function is initializing the UART2(pin 3.2,3.3) for sending distance message to the console with baud rate of 9600

*

*/

void UART2_init()

{

//pin 3.2 RX pin 3.3 TX

// Configure UART pins

P3->SEL0 |= BIT2 | BIT3; // set 2-UART pin as secondary function

P3->SEL1 &= ~(BIT2 | BIT3);

// Configure UART

EUSCI_A2->CTLW0 |= EUSCI_A_CTLW0_SWRST; // Put eUSCI in reset

EUSCI_A2->CTLW0 |= EUSCI_B_CTLW0_SSEL__SMCLK; // Configure eUSCI clock source for SMCLK

// Baud Rate calculation

// 12000000/(16*9600) = 78.125

// Fractional portion = 0.125

// User's Guide Table 21-4: UCBRSx = 0x10

// UCBRFx = int ( (78.125-78)*16) = 2

EUSCI_A2->BRW = 78; // 12000000/16/9600

EUSCI_A2->MCTLW = (2 << EUSCI_A_MCTLW_BRF_OFS) |

EUSCI_A_MCTLW_OS16;

EUSCI_A2->CTLW0 &= ~EUSCI_A_CTLW0_SWRST; // take eUSCI out of reset mode

EUSCI_A2->IFG &= ~EUSCI_A_IFG_RXIFG; // Clear eUSCI RX interrupt flag

EUSCI_A2->IE &= ~EUSCI_A_IE_RXIE; // Disable USCI_A2 RX interrupt

}

/**

* This function puts a string to transmit buffer in the UART2, which will be sent to console

*/

int UART2_puts(const char *str)

{

int status = -1;

if (str != '\0') {

status = 0;

while (*str != '\0') {

/* Wait for the transmit buffer to be ready */

while (!(EUSCI_A2->IFG & EUSCI_A_IFG_TXIFG));

/* Transmit data */

EUSCI_A2->TXBUF = *str;

str++;

}

}

return status;

}

int UART2_gets(char *str)

{

while (1) {

/* Wait for the receive buffer to be ready */

while (!(EUSCI_A2->IFG & EUSCI_A_IFG_RXIFG));

/* Transmit data */

*str = EUSCI_A2->RXBUF;

if(*str == '\n' || *str == '\0')

{

break;

}

str++;

}

return 1;

}

_______________________________

"us.h"

#include "msp.h"

#include <stdint.h>

#include <stdio.h>

//higher number has lower priority

#define PORT4_PRIO 4

#define TIMEA0_PRIO 3

#define INTR_PRD 1000

#define DIST_DIV 1400

#define SAMPLE_SIZE 3

//This function initializes the clock signal

void Clock_init();

//This function initializes the TIMERA0 for recording time_stamp

void TIMERA0_init();

//This function initializes pins for trigger ultrasonic sensor and record echo signals.

//It uses pin 4.6 as trigger and pin 4.7 for echo. It also registers IRQ for receiving interrupt from rising or falling edge at pin 4.7

void US_init();

//This function measures the distance between the ultrasonic sensor and the object in front of it.

//It triggers the sensor several times and return the average value in cm.

//The specific size of the sample can be modified by changing the macro in us.h. The range of distance is (0, 300)

long measure_dist();

//This function returns the time passed since the start of the measurement (marked by US_init). The time stamp is record as â€œmin,secâ€ in string

char* get_time_stamp();

void Delay(uint32_t tick);

us.c

#include "us.h"

long intrcnt = 0;

long clktick = 0;

long start = 0;

long end = 0;

int min = 0;

int sec = 0;

char buffer[20];

long US_scan_once();

void Clock_init()

{

//setting up clock signals

CS->KEY = CS_KEY_VAL; // Unlock CS module for register access

CS->CTL0 = 0; // Reset tuning parameters

CS->CTL0 = CS_CTL0_DCORSEL_3; // Set DCO to 24MHz

CS->CTL1 = CS_CTL1_SELA_2 | // Select ACLK = REFO

CS_CTL1_SELS_3 | // SMCLK = DCO

CS_CTL1_SELM_3; // MCLK = DCO

CS->KEY = 0; // Lock CS module from unintended accesses

}

void TIMERA0_init()

{

//setting up timer A0

TIMER_A0->CCTL[0] = TIMER_A_CCTLN_CCIE; // CCR0 interrupt enabled

TIMER_A0->CCR[0] = INTR_PRD - 1; // interrupt is raised for every 1000 clock tick

TIMER_A0->CTL = TIMER_A_CTL_TASSEL_2 | TIMER_A_CTL_MC__UP | TIMER_A_CTL_CLR; // SMCLK, upmode, TA clear

// Enable Timer interrupt for timing and set priority as 3

NVIC_SetPriority(TA0_0_IRQn, TIMEA0_PRIO);

NVIC_EnableIRQ(TA0_0_IRQn);

}

void US_init()

{

// Configure GPIO

//set P4 as GPIO

P4->SEL0 = 0;

P4->SEL1 = 0;

// uses P4.7 as echo

P4->DIR &= ~BIT7; // P4.7 as input pin

P4->REN |= BIT7; // P4.7 pull resistor enabled

P4->OUT &= ~BIT7; // P4.7 selected as pull down (active low)

// uses P4.6 as trigger

P4->DIR |= BIT6; // trigger pin as output

// receiving interrupt from P4.7

P4->IFG = 0; // clean pending interrupt flag

P4->IES &= ~BIT7; // enable rising edge interrupt

P4->IE |= BIT7; // enable interrupt

// Enable Port4 interrupt for echo and set priority as 4

NVIC_SetPriority(PORT4_IRQn, PORT4_PRIO);

NVIC_EnableIRQ(PORT4_IRQn);

}

/**

* This function delay for the given amount of clock cycle

*/

void Delay(uint32_t tick)

{

// initialize timer32 1 with give amount of tick

TIMER32_1->LOAD = tick;

//no prescaler, periodic wrapping mode, disable interrupt, 32-bit timer

TIMER32_1->CONTROL = 0xc2;

//spin wait until the time is reached

while ((TIMER32_1->RIS & 1) == 0)

;

TIMER32_1->INTCLR = 0; //clear raw interrupt flag

}

long US_scan_once()

{

// uses pin 4.6 for trigger

P4->OUT |= BIT6; // generate pulse

Delay(240); // 240 cycle in 24mhz is about 10us

P4->OUT &= ~BIT6; // stop pulse

P4->IFG = 0; // clear P4 interrupt just in case anything happened before

P4->IES &= ~BIT7; // wait for rising edge on ECHO pin

Delay(660000); //set this to 100us - 60ms

if(end > start)

{

return (end - start) / DIST_DIV; // converting ECHO time into cm

}

else

{

return 300;

}

}

long measure_dist()

{

long res = 0;

int i;

for(i = 0; i < SAMPLE_SIZE; i++)

{

long dist = US_scan_once();

if(dist > 300)

res += 300;

else

res += dist;

}

return res/SAMPLE_SIZE;

}

char* get_time_stamp()

{

sec = intrcnt / 24000;

min = sec / 60;

sec %= 60;

sprintf(buffer, "%d,%d", min, sec);

return buffer;

}

/**

* Port4 interrupt service routine, start timing echo from rising edge to falling edge

*/

void PORT4_IRQHandler(void)

{

// check if interrupt is pending for P4.7

if (P4->IFG & BIT7)

{

//if we are checking for raising edge, we are at the beginning of the echo

if (!(P4->IES & BIT7 ))

{

//record starting time of the echo

start = intrcnt * 1000 + (long) TIMER_A0->R;

//now checks for falling edge, which is the end of the echo

P4->IES |= BIT7;

}

else

{

end = intrcnt * 1000 + (long) TIMER_A0->R; //calculating ECHO length

//now back to checking rising edge, which is the beginning of the echo

P4->IES &= ~BIT7;

}

P4->IFG &= ~BIT7; //clear flag

}

}

/**

* TimerA0 interrupt service routine, updates count of interrupt and clears interrupt flag

*/

void TA0_0_IRQHandler(void)

{

// Interrupt gets triggered for every 1000 clock cycle in SMCLK

intrcnt++;

TIMER_A0->CCTL[0] &= ~TIMER_A_CCTLN_CCIFG;

}

Systick0.h

// Header to initialize SysTick for simple delay in ms or us

#include "msp.h"

#include <stdio.h>

void SysTick_Init();

void SysTick_Delayms();

void SysTick_Delayus();

Systick0.c

// Functions to initialize SysTick for simple delay in ms or us

#include "msp.h"

#include <stdio.h>

#include "SysTick0.h"

void SysTick_Init();

void SysTick_Delayms();

void SysTick_Delayus();

// Function to initialize SysTick without interrupt enable

// No longer necessary, delay functions work indpendently

void SysTick_Init(){

SysTick->CTRL = 0; // disable

SysTick->LOAD = 0x00FFFFFF; // set reload to max

SysTick->VAL = 0; // clear counter value

SysTick->CTRL = 0x00000005 ; // set CLKSOURCE to core clock and enable to 1

// clock is 3MHz, CTRL has interrupts disabled

// tech reference manual 2.4.4.1

return;

}

// Delay function with argument in milliseconds

void SysTick_Delayus(int time){

SysTick->LOAD = (time * 3 - 1); // 3000t / 3 MHz = t ms

// minimum 25 us, scales oddly until ~100 us

SysTick->VAL = 0; // any write to VAL clears VAL, restart

SysTick->CTRL = 0x00000005 ; // set CLKSOURCE to core clock and enable to 1

while(!(SysTick->CTRL & 0x00010000)); // stays in loop until COUNTFLAG is true

return;

}

// Delay function with argument in milliseconds

void SysTick_Delayms(int time){

SysTick->LOAD = (time * 3000 - 1); // 3000t / 3 MHz = t ms

SysTick->VAL = 0; // any write to VAL clears VAL, restart

SysTick->CTRL = 0x00000005 ; // set CLKSOURCE to core clock and enable to 1

while(!(SysTick->CTRL & 0x00010000)); // stays in loop until COUNTFLAG is true

return;

}
