Albert-HY-Jiang/Buggy-for-Neural-Navigation/doc/weekly reports/2-26 bluetooth log.docx

# Guide to Connect HC-06 Bluetooth Module

1. Power the HC-06 module with 5/3.3V to Vcc pin, and ground to GND pin. The LED will start flashing if the module is ready to connect.
2. Select find Bluetooth device on the laptop, make sure to choose “find all devices”. The name “HC-06” will show up. Enter the default pin “1234” to connect.
3. After pairing is completed, the device will be shown as “not connected”. This is expected. Under the Bluetooth device settings, there should be two new COM Ports added called “HC-06 port” and “HC-06”.
4. Use a terminal monitor, like TeraTerm or CoolTerm, to connect to serial port with name “HC-06 port” with outgoing direction. The LED on the device will stay on if the connection is successfully established.

# Communicate with HC-06 with UART

1. HC-06 has two pins, “TX” and “RX”, for UART communication. Any serial input to the RX pin will be transmitted to the connected serial port by the HC-06 module. Similarly, any serial data received by the HC-06 will be transmitted to the TX pin.

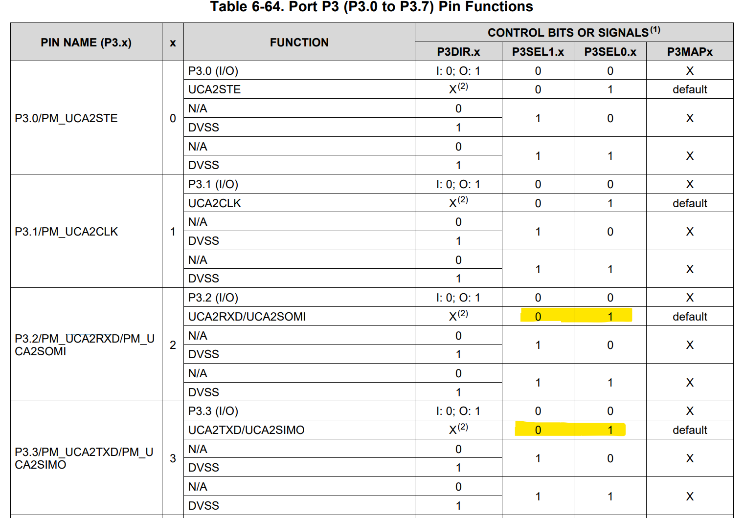
[picture p15: figure]

2. MSP432P401R has UART port available on the pins. The UART mode can be initiated by adjusting the control bit. For example, to set pin3.2 and pin3.3 to the UART mode, we need follow the table below

Set the P3SEL1.2/P3SEL1.3 = 0 and the P3SEL0.2/P3SEL0.3 = 1. It can be done by the code below.

3. For the wire connection, pin 3.2 RX need to be connected to TX on HC-06, and pin 3.3 TX need to be connected to RX on HC-06.
4. Then for transmitting data, it will be the same for regular UART functions. Wait for the flag for buffer to be ready and write the char data to the buffer.

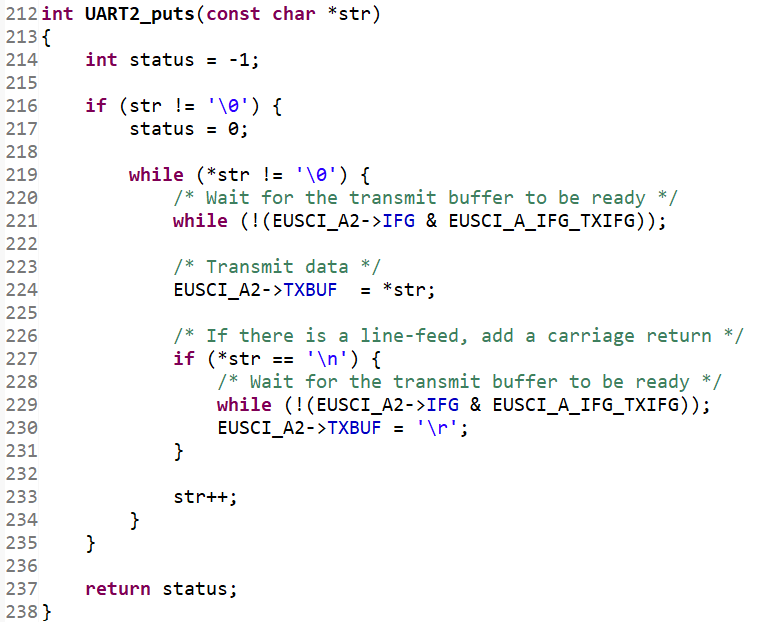
[picture p16: figure]

# Guide to Capture Serial Input with CoolTerm

1. Download CoolTerm on the official website https://freeware.the-meiers.org/
2. Unzip and start the program
3. Select Connection -> File Capture -> Start. A window will pop out to ask to save the file.

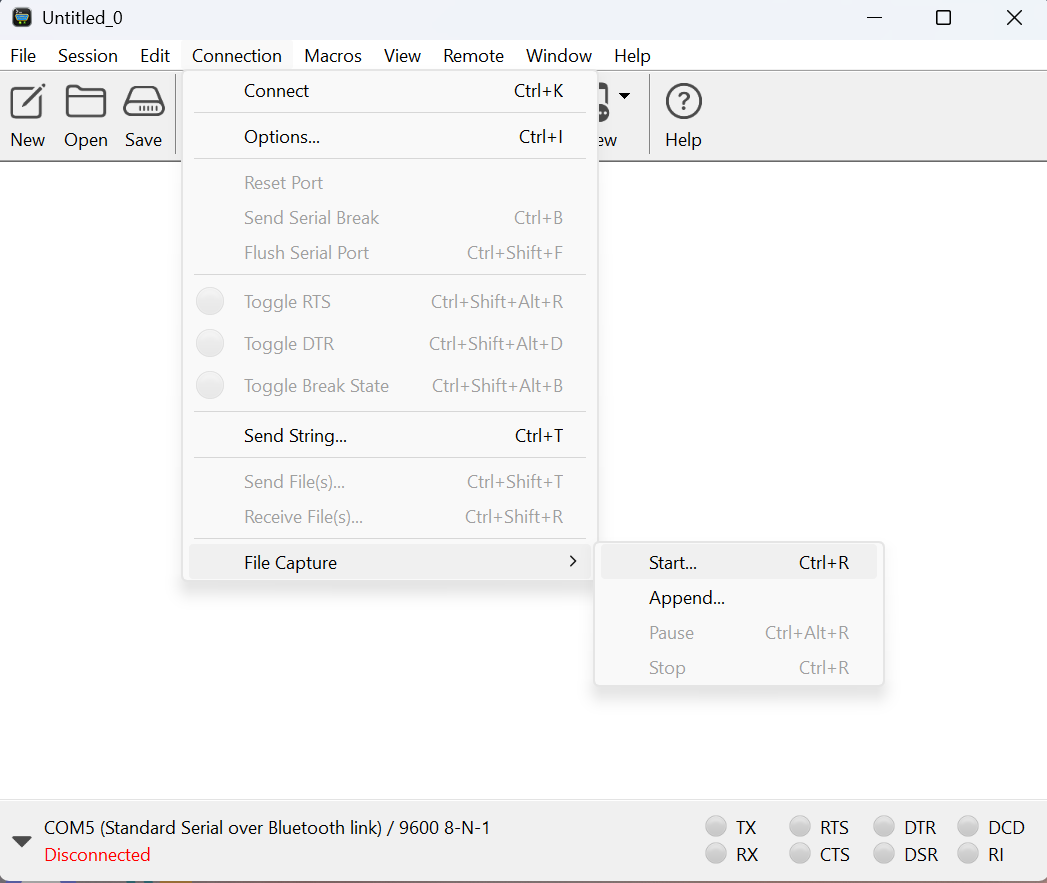
[picture p17: figure]

4. After saving the txt file, the connection can be started by clicking the arrow at the bottom left corner.
5. The setting for the connection can also be adjusted at the drop down manual.

Nearest distance by USG sensor – 1.97cm, longest sensor – 2.97m.

Distance between triggers should be more than 60 ms.

Appendix

#include "msp.h"

#include <stdint.h>

#include <stdio.h>

//higher number has lower priority

#define PORT2_PRIO 4

#define TIMEA0_PRIO 3

#define MCLKFREQ

#define INTR_PRD 1000

#define DIST_DIV 1400

//according to HCSR-04 datasheet, trigger length is 10us and max echo length is 60ms

//by my measurement, the echo length is from 135us to 55ms

long intrcnt = 0;

long distance = 0;

long clktick = 0;

long timestamp = 0;

long start = 0;

long end = 0;

void UART0_init();

int UART0_puts(const char *str);

void UART2_init();

int UART2_puts(const char *str);

void Delay(uint32_t tick);

long measure_dist();

void get_time_stamp();

int min = 0;

int sec = 0;

/**

* The main function initializes all port, including, UART, trigger, echo. And keep triggering

* the ultrasonic sensor and send the distance converted from echo length to the console

*/

int main(void)

{

WDT_A->CTL = WDT_A_CTL_PW | // Stop watchdog timer

WDT_A_CTL_HOLD;

//setting up clock signals

CS->KEY = CS_KEY_VAL; // Unlock CS module for register access

CS->CTL0 = 0; // Reset tuning parameters

CS->CTL0 = CS_CTL0_DCORSEL_3; // Set DCO to 24MHz

CS->CTL1 = CS_CTL1_SELA_2 | // Select ACLK = REFO

CS_CTL1_SELS_3 | // SMCLK = DCO

CS_CTL1_SELM_3; // MCLK = DCO

CS->KEY = 0; // Lock CS module from unintended accesses

UART2_init();

// Configure GPIO

// Setting up LED for distance detecting

P1->DIR |= BIT0; // Set P1.0 as output

//set p2 as GPIO

P2->SEL0 = 0;

P2->SEL1 = 0;

// uses p2.7 as echo

P2->DIR &= ~BIT7; // P2.7 as input pin

P2->REN |= BIT7; // P2.7 pull resistor enabled

P2->OUT &= ~BIT7; // P2.7 selected as pull down (active low)

// uses p2.6 as trigger

P2->DIR |= BIT6; // trigger pin as output

// receiving interrupt from p2.7

P2->IFG = 0; // clean pending interrupt flag

P2->IES &= ~BIT7; // enable rising edge interrupt

P2->IE |= BIT7; // enable interrupt

//setting up timer A0

TIMER_A0->CCTL[0] = TIMER_A_CCTLN_CCIE; // CCR0 interrupt enabled

TIMER_A0->CCR[0] = INTR_PRD - 1; // interrupt is raised for every 1000 clock tick

TIMER_A0->CTL = TIMER_A_CTL_TASSEL_2 | TIMER_A_CTL_MC__UP | TIMER_A_CTL_CLR; // SMCLK, upmode, TA clear

// Enable Port2 interrupt for echo and set priority as 4

NVIC_SetPriority(PORT2_IRQn, PORT2_PRIO);

NVIC_EnableIRQ(PORT2_IRQn);

// Enable Timer interrupt for timing and set priority as 3

NVIC_SetPriority(TA0_0_IRQn, TIMEA0_PRIO);

NVIC_EnableIRQ(TA0_0_IRQn);

__enable_irq(); // Enables interrupts to the system

//blink twice before it begin

P1->OUT |= BIT0;

Delay(24000000);

P1->OUT &= ~BIT0;

Delay(24000000);

P1->OUT |= BIT0;

Delay(24000000);

P1->OUT &= ~BIT0;

intrcnt = 0;

while (1)

{

distance = measure_dist();

get_time_stamp();

char buffer[50];

sprintf(buffer, "%d:%d, %d\n", min,sec, distance); // format the output string

UART2_puts(buffer);

//turning LED on if distance is less than certain range and if distance isn't 0.

if (distance < 50 && distance != 0)

P1->OUT |= BIT0;

else

P1->OUT &= ~BIT0;

Delay(300000);

}

}

/**

* This function is initializing the UART0 for sending distance message to the console with baud rate of 9600

*

*/

void UART0_init()

{

// Configure UART pins

P1->SEL0 |= BIT2 | BIT3; // set 2-UART pin as secondary function

// Configure UART

EUSCI_A0->CTLW0 |= EUSCI_A_CTLW0_SWRST; // Put eUSCI in reset

EUSCI_A0->CTLW0 |= EUSCI_B_CTLW0_SSEL__SMCLK; // Configure eUSCI clock source for SMCLK

// Baud Rate calculation

// 12000000/(16*9600) = 78.125

// Fractional portion = 0.125

// User's Guide Table 21-4: UCBRSx = 0x10

// UCBRFx = int ( (78.125-78)*16) = 2

EUSCI_A0->BRW = 78; // 12000000/16/9600

EUSCI_A0->MCTLW = (2 << EUSCI_A_MCTLW_BRF_OFS) |

EUSCI_A_MCTLW_OS16;

EUSCI_A0->CTLW0 &= ~EUSCI_A_CTLW0_SWRST; // take eUSCI out of reset mode

EUSCI_A0->IFG &= ~EUSCI_A_IFG_RXIFG; // Clear eUSCI RX interrupt flag

EUSCI_A0->IE &= ~EUSCI_A_IE_RXIE; // Disable USCI_A0 RX interrupt

}

/**

* This function puts a string to transmit buffer in the UART0, which will be sent to console

*/

int UART0_puts(const char *str)

{

int status = -1;

if (str != '\0')

{

status = 0;

while (*str != '\0')

{

/* Wait for the transmit buffer to be ready */

while (!(EUSCI_A0->IFG & EUSCI_A_IFG_TXIFG))

;

/* Transmit data */

EUSCI_A0->TXBUF = *str;

/* If there is a line-feed, add a carriage return */

if (*str == '\n')

{

/* Wait for the transmit buffer to be ready */

while (!(EUSCI_A0->IFG & EUSCI_A_IFG_TXIFG))

;

EUSCI_A0->TXBUF = '\r';

}

str++;

}

}

return status;

}

void UART2_init()

{

//pin 3.2 RX pin 3.3 TX

// Configure UART pins

P3->SEL0 |= BIT2 | BIT3; // set 2-UART pin as secondary function

P3->SEL1 &= ~(BIT2 | BIT3);

// Configure UART

EUSCI_A2->CTLW0 |= EUSCI_A_CTLW0_SWRST; // Put eUSCI in reset

EUSCI_A2->CTLW0 |= EUSCI_B_CTLW0_SSEL__SMCLK; // Configure eUSCI clock source for SMCLK

// Baud Rate calculation

// 12000000/(16*9600) = 78.125

// Fractional portion = 0.125

// User's Guide Table 21-4: UCBRSx = 0x10

// UCBRFx = int ( (78.125-78)*16) = 2

EUSCI_A2->BRW = 78; // 12000000/16/9600

EUSCI_A2->MCTLW = (2 << EUSCI_A_MCTLW_BRF_OFS) |

EUSCI_A_MCTLW_OS16;

EUSCI_A2->CTLW0 &= ~EUSCI_A_CTLW0_SWRST; // take eUSCI out of reset mode

EUSCI_A2->IFG &= ~EUSCI_A_IFG_RXIFG; // Clear eUSCI RX interrupt flag

EUSCI_A2->IE &= ~EUSCI_A_IE_RXIE; // Disable USCI_A2 RX interrupt

}

int UART2_puts(const char *str)

{

int status = -1;

if (str != '\0') {

status = 0;

while (*str != '\0') {

/* Wait for the transmit buffer to be ready */

while (!(EUSCI_A2->IFG & EUSCI_A_IFG_TXIFG));

/* Transmit data */

EUSCI_A2->TXBUF = *str;

/* If there is a line-feed, add a carriage return */

if (*str == '\n') {

/* Wait for the transmit buffer to be ready */

while (!(EUSCI_A2->IFG & EUSCI_A_IFG_TXIFG));

EUSCI_A2->TXBUF = '\r';

}

str++;

}

}

return status;

}

/**

* This function delay for the given amount of clock cycle

*/

void Delay(uint32_t tick)

{

// initialize timer32 1 with give amount of tick

TIMER32_1->LOAD = tick;

//no prescaler, periodic wrapping mode, disable interrupt, 32-bit timer

TIMER32_1->CONTROL = 0xc2;

//spin wait until the time is reached

while ((TIMER32_1->RIS & 1) == 0)

;

TIMER32_1->INTCLR = 0; //clear raw interrupt flag

}

long measure_dist()

{

// uses pin 2.6 for trigger

P2->OUT |= BIT6; // generate pulse

Delay(240); // 240 cycle in 24mhz is about 10us

P2->OUT &= ~BIT6; // stop pulse

P2->IFG = 0; // clear P2 interrupt just in case anything happened before

P2->IES &= ~BIT7; // wait for rising edge on ECHO pin

Delay(660000);

if(end > start)

{

return (end - start) / DIST_DIV; // converting ECHO time into cm

}

else

{

return 0;

}

}

void get_time_stamp()

{

sec = intrcnt / 24000;

min = sec / 60;

sec %= 60;

}

/**

* Port2 interrupt service routine, start timing echo from rising edge to falling edge

*/

void PORT2_IRQHandler(void)

{

// check if interrupt is pending for p2.7

if (P2->IFG & BIT7)

{

//if we are checking for raising edge, we are at the beginning of the echo

if (!(P2->IES & BIT7 ))

{

//record starting time of the echo

start = intrcnt * 1000 + (long) TIMER_A0->R;

//now checks for falling edge, which is the end of the echo

P2->IES |= BIT7;

}

else

{

end = intrcnt * 1000 + (long) TIMER_A0->R; //calculating ECHO length

//now back to checking rising edge, which is the beginning of the echo

P2->IES &= ~BIT7;

}

P2->IFG &= ~BIT7; //clear flag

}

}

/**

* TimerA0 interrupt service routine, updates count of interrupt and clears interrupt flag

*/

void TA0_0_IRQHandler(void)

{

// Interrupt gets triggered for every 1000 clock cycle in SMCLK

intrcnt++;

TIMER_A0->CCTL[0] &= ~TIMER_A_CCTLN_CCIFG;

}
